ConsortiumRR/ROSE/Research Files/RFMI6472.JPG

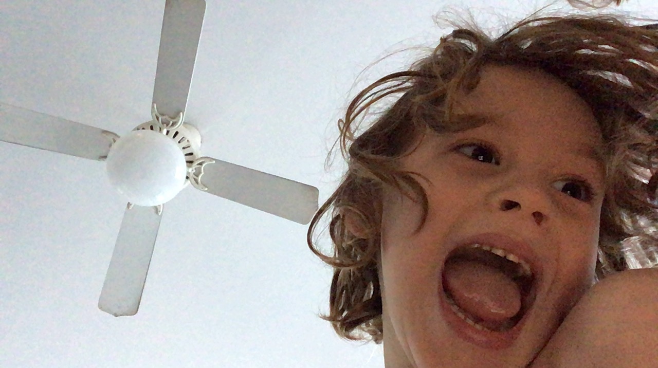
Research Files/RFMI6472.JPG
