ConsortiumRR/ROSE/R_ose_Hub/R_ose_Hub.ino

//____________________________________________________________________________________________________//
//-----------------------------------------------ROSE-HUB---------------------------------------------//
//____________________________________________________________________________________________________//

#include <esp_now.h>
#include <WiFi.h>
//------------------------------------------ESP-NOW-VARIABLES-----------------------------------------//

// Below is a data structure is defined which allows the ESP32 to receive wireless messages from the senders
// It can be modified to receive whatever variable types you want - floats, strings, char, etc
// This structure must match the sender structure


typedef struct struct_message {
  int id;
  int moistureLevel;
  bool isTooDry;
} struct_message;



// Create a struct_message called myData
struct_message myData;

// Create a structure to hold the readings from each unit
struct_message unit1;
struct_message unit2;
struct_message unit3;


// Create an array with all the structures
struct_message unitsStruct[] = {unit1, unit2, unit3};



// Callback function that will be executed when data is received
void OnDataRecv(const uint8_t * mac_addr, const uint8_t *incomingData, int len) {
  char macStr[18];
  Serial.print("Packet received from: ");
  snprintf(macStr, sizeof(macStr), "%02x:%02x:%02x:%02x:%02x:%02x",
           mac_addr[0], mac_addr[1], mac_addr[2], mac_addr[3], mac_addr[4], mac_addr[5]);
  Serial.println(macStr);

  memcpy(&myData, incomingData, sizeof(myData));
  
//  Serial.printf("unit ID %u: %u bytes\n", myData.id, len);
  
  
  // Update the structures with the new incoming data 
  unitsStruct[myData.id - 1].moistureLevel = myData.moistureLevel;
  unitsStruct[myData.id - 1].isTooDry = myData.isTooDry;
//
//  Serial.printf("x: %d \n", unitsStruct[myData.id - 1].x);
//  Serial.println();
}


//----------------------------------------------------------------------------------------------------//




//---------------------------------------ROBOT-COMS-VARIABLES-----------------------------------------//
int numUnits = 3;
int numBits = 4;

int READPIN = 36;
int bit0 = 23;
int bit1 = 16;
int bit2 = 19;
int bit3 = 18;

int doPin[] = {bit0, bit1, bit2, bit3};
bool queryRecieved = false;


unsigned long pulseDuration;




void setup() {
  // Initialize Serial Monitor
  Serial.begin(115200);

  //set pins to output and input
  for (int indexPin = 0; indexPin < numBits; indexPin++) {
    pinMode (doPin[indexPin], OUTPUT);
  }

  pinMode(READPIN, INPUT);


  // Set device as a Wi-Fi Station
  WiFi.mode(WIFI_STA);
  WiFi.disconnect();

  // Init ESP-NOW
  if (esp_now_init() != 0) {
    Serial.println("Error initializing ESP-NOW");
    return;
  }

  // Once ESPNow is successfully Init, we will register for recv CB to
  // get recv packer info
  esp_now_register_recv_cb(OnDataRecv);


}

void loop() {

  //updating an array of bools. 1 = unit switched on. 0 = unit switched off.
  
  
  //messages coming from the robot
  pulseDuration = pulseIn(READPIN, HIGH);

  if(pulseDuration >= 4500 && pulseDuration <= 5500){
    queryRecieved = true;
  }
  
  if (queryRecieved == true) {
    Serial.println("query recieved");

    for(int i = 0; i<numUnits; i++){
      if(unitsStruct[i].isTooDry == 1){
        
        //sets 'queryRecieved' to false to enforce one input/one output
        queryRecieved == false;

        //prints
        Serial.print("go to unit ");
        Serial.print(i+1);
        Serial.println();
      
        displayBinary(i+1);  
        delay(500);
        displayBinary(0);
        
        break;
      }
    }  
  }
  
  else if (queryRecieved == false)
  { 
        displayBinary(0);
  }

  
}

void displayBinary(byte number) {

  for (int i = 0; i < numBits; i++) {
    if (bitRead(number, i) == 1) {
      digitalWrite(doPin[i], HIGH);
    }
    else {
      digitalWrite(doPin[i], LOW);
    }
  }
}
