ConsortiumRR/ROSE/(commit log)

2020-10-27 Create R_ose Sensor and Microcontroller Manual.pdf
2020-10-28 Added Folder and ROSEProto Rapid code
    Added initial rapid files for rose prototype adapted from useless machine. Includes hub IO comm, watering function and tool loading functionality- program data is not setup
2020-11-04 inOrder sender sketch
    changing sender to only send during switch state change
2020-11-05 Adding Folder for Face Recognition
    Uploaded the Arduino and Processing Code for the Face Tracking Module use-case
2020-11-20 Added Code for Hub Serial Relay
    Sketch allowing the hub to relay signals from robot IOs to UART serial
2020-11-23 Working Test
    Updated and tested. Changed ABB file to use 4bit group output instead of 8bit. Changed ESP32 to use math based binary signal to int read function rather than standard bit shift functions.
2021-01-14 Create CPXLightDisplay
    Basic led display for circuit playground using 4bit IO signals passed via UART
2021-05-12 Uploaded Final HuskyLens NodeRed Safety Implementation
    Includes edited HuskyLens Library as well as Working ESP32 code and the Node-Red Json. Everything you might need to get this working for yourself.
